TimGrundstein/cse_seminar_rechenautomat/misc/presentation/CSE_Seminar_Rechenmaschine.pdf

# Rekonstruktion &

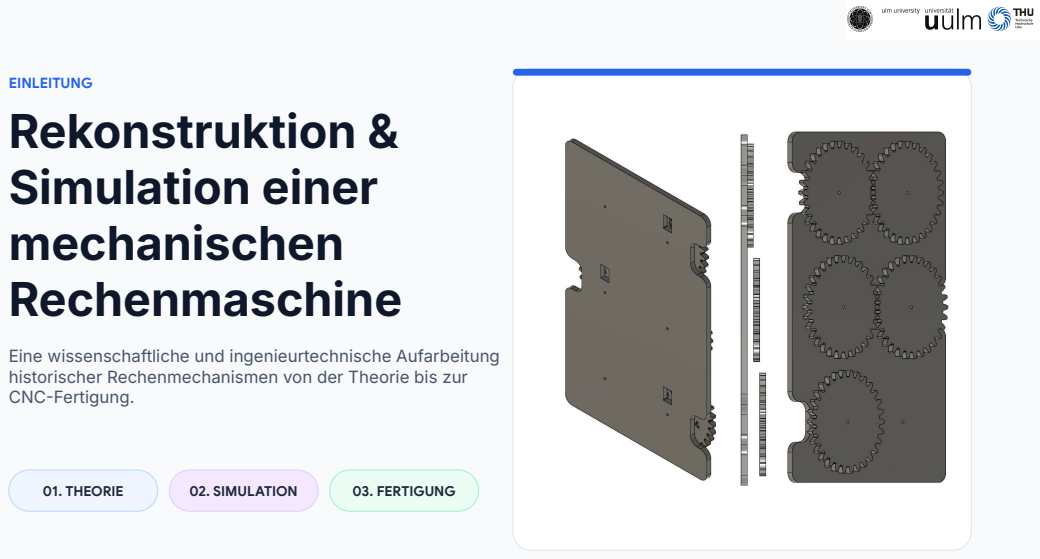
[picture p1: page 1]
EINLEITUNG Simulation einer mechanischen Rechenmaschine; 01. THEORIE; 02. SIMULATION; 03. FERTIGUNG

Eine wissenschaftliche und ingenieurtechnische Aufarbeitung
historischer Rechenmechanismen von der Theorie bis zur
CNCFertigung.

EINLEITUNG

# Gliederung

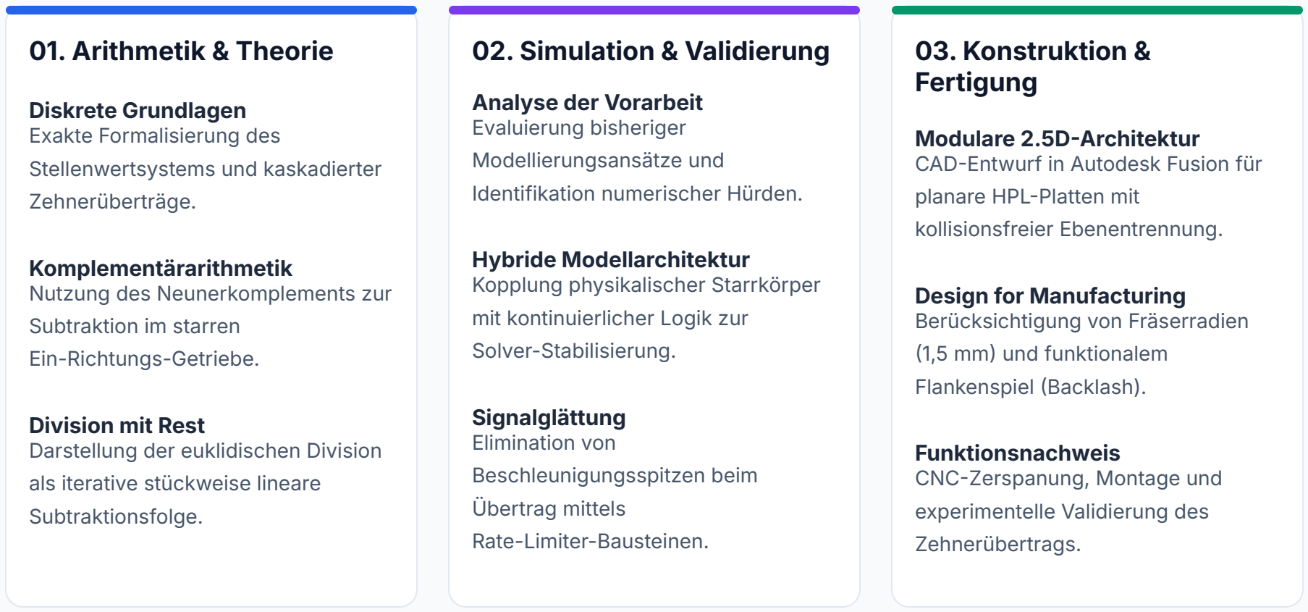
[picture p2: figure]
01. Arithmetik & Theorie; Diskrete Grundlagen Exakte Formalisierung des Stellenwertsystems und kaskadierter Zehnerüberträge.; Komplementärarithmetik Nutzung des Neunerkomplements zur Subtraktion im starren Ein-Richtungs-Getriebe.; Division mit Rest Darstellung der euklidischen Division als iterative stückweise lineare Subtraktionsfolge.; 02. Simulation & Validierung; Analyse der Vorarbeit Evaluierung bisheriger Modellierungsansätze und Identifikation numerischer Hürden.; Hybride Modellarchitektur Kopplung physikalischer Starrkörper mit kontinuierlicher Logik zur Solver-Stabilisierung.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

EINLEITUNG

# Methodik

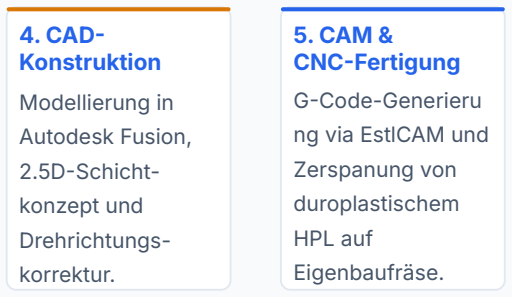
[picture p3: figure]
5. CAM & CNCFertigung GCode-Generieru ng via EstlCAM und Zerspanung von duroplastischem HPL auf Eigenbaufräse.; 4. CAD Konstruktion; Modellierung in Autodesk Fusion, 2.5DSchicht- konzept und Drehrichtungs- korrektur.

### 1. Theorie &

Historie
Analyse der
Pascaline, des
Sautoir-Prinzips
und der linearen
Komplementärarithmetik.

### 2. Vorarbeits-

analyse
Evaluierung der
Vorarbeit +
Identifikation
relevanter
Modellierungsansätze.

### 3. Hybride

Simulation
Aufbau des
Simscape- Modells
mit zehneckigen
Prismen und
diskretem
Sautoir-Code.

### 6. Test &

Synthese
Montage, Justage
mit Kontermuttern,
Toleranzanalyse
und Vergleich mit
3DDruck.

THEORIE & GRUNDLAGEN

# Die Pascaline

## Historischer Hintergrund & Motivation

Entstehungsanlass 1642
- Entwickelt von Blaise Pascal zur Unterstützung seines Vaters Étienne Pascal (königlicher Steuerkommissar in der Normandie)

Nicht-dezimales Währungssystem
- Historische Stückelung: 1 Livre = 20 Sous, 1 Sous = 12 Deniers → manuelle Abrechnung extrem fehleranfällig

Entwicklungsaufwand & Monopolprivileg
- Bau von rund 50 Prototypen bis 1645, sowie königliches Schutzprivileg durch Ludwig XIV. im Jahr 1649

Uhrmachertechnische Grenzen
- Hohe Reibung, Schmutzanfälligkeit und hohe Herstellungskosten begrenzten die damalige Verbreitung

https://press.christies.com/wp-content/uploads/2025/09/3f1f6d892af576e9f1f71e5117f32f54_330069-l.jpg

THEORIE & GRUNDLAGEN

# Kinematik & Aufbau der Pascaline

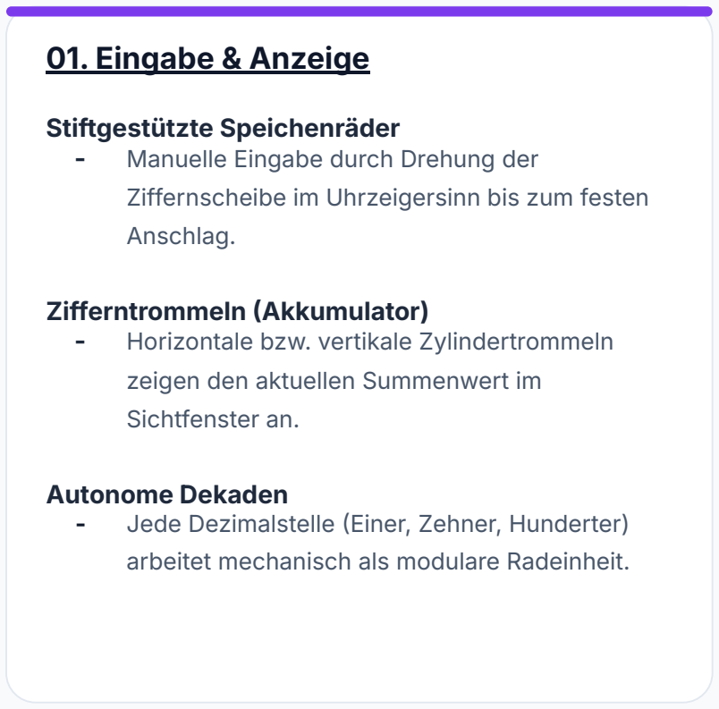
[picture p4: figure]
01. Eingabe & Anzeige; Stiftgestützte Speichenräder - Manuelle Eingabe durch Drehung der; Anschlag.; Zifferntrommeln Akkumulator); zeigen den aktuellen Summenwert im Sichtfenster an.; Autonome Dekaden; arbeitet mechanisch als modulare Radeinheit.

Ziffernscheibe im Uhrzeigersinn bis zum festen

- Horizontale bzw. vertikale Zylindertrommeln
- Jede Dezimalstelle Einer, Zehner, Hunderter)

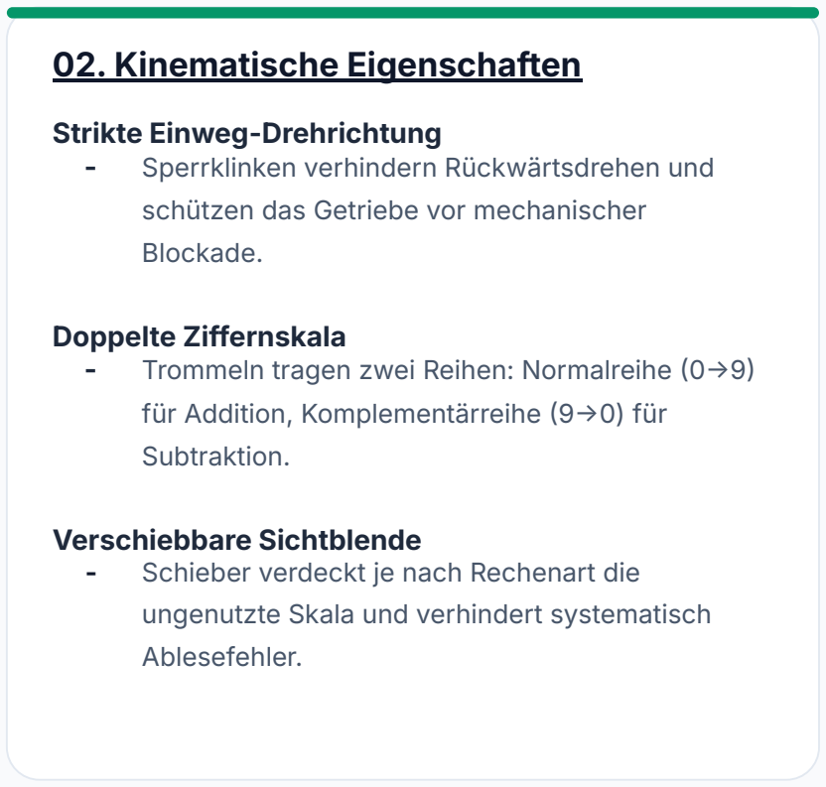
[picture p5: figure]
02. Kinematische Eigenschaften; Strikte Einweg-Drehrichtung; schützen das Getriebe vor mechanischer Blockade.; Doppelte Ziffernskala; für Addition, Komplementärreihe 90) für Subtraktion.; Verschiebbare Sichtblende; ungenutzte Skala und verhindert systematisch Ablesefehler.

- Sperrklinken verhindern Rückwärtsdrehen und
- Trommeln tragen zwei Reihen: Normalreihe 09
- Schieber verdeckt je nach Rechenart die

THEORIE & GRUNDLAGEN

# Der Sautoir: Schwerkraft-Zehnerübertrag

## Lösung des mechanischen Kaskadenproblems

Das mechanische Kaskadenproblem
- Bei simultanen Überträgen (z. B. 999 1) addieren sich die Reibungskräfte starr gekoppelter Räder auf und blockieren das Getriebe.

Schwerkraftgestützte Energiespeicherung
- Beim Drehen von 4 auf 9 hebt ein Nocken den Hebelarm Sautoir) kontinuierlich an und speichert potentielle Energie.

Schlagartiger Impulsübertrag
- Beim Übergang von 9 auf 0 fällt der Sautoir durch sein Eigengewicht herab und schaltet das Folgerad um z.B. 36° weiter.

Kinematische Entkopplung
- Die Antriebskraft des Bedieners wirkt nur lokal. Der Zehnerübertrag erfolgt energetisch autark.

https://upload.wikimedia.org/wikipedia/commons/b/b0/Sautoir-Animation.gif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

THEORIE & GRUNDLAGEN

# Subtraktion durch Neunerkomplement

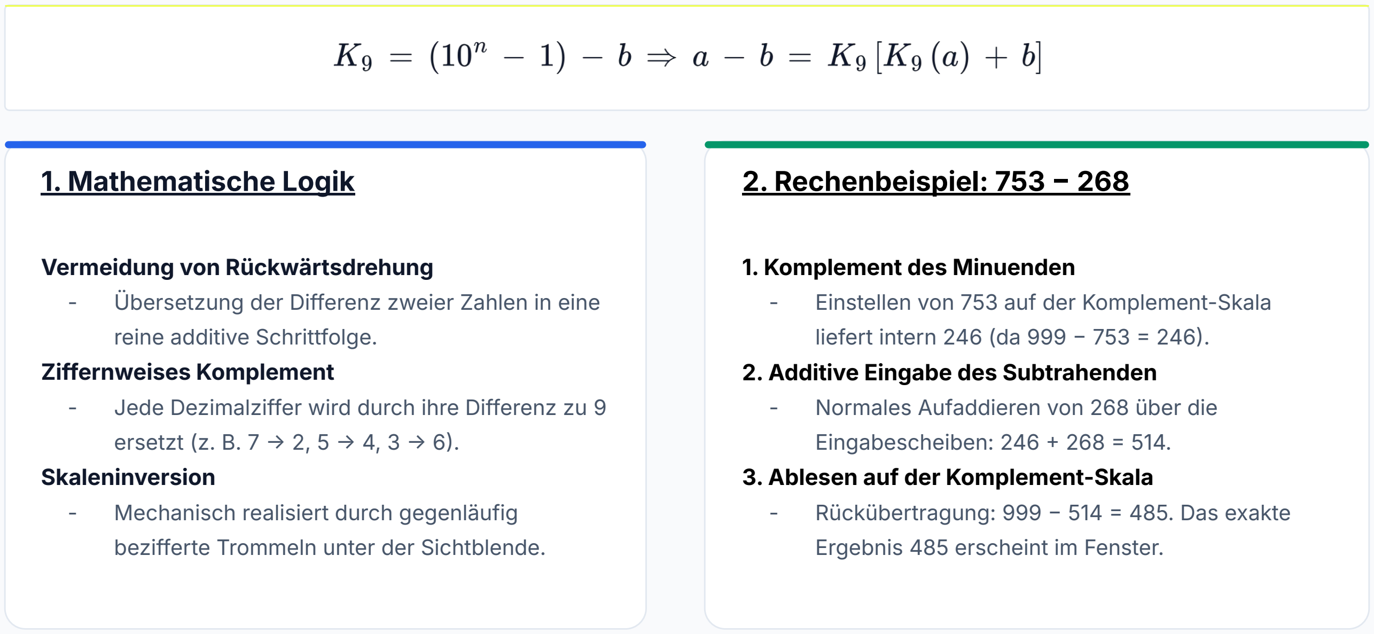
[picture p6: figure]
1. Mathematische Logik; Vermeidung von Rückwärtsdrehung; reine additive Schrittfolge. Ziffernweises Komplement; ersetzt (z. B. 7 2, 5 4, 3 6. Skaleninversion; bezifferte Trommeln unter der Sichtblende.; 2. Rechenbeispiel: 753 268; 1. Komplement des Minuenden; 2. Additive Eingabe des Subtrahenden - Normales Aufaddieren von 268 über die Eingabescheiben: 246 268 514. 3. Ablesen auf der Komplement-Skala; Ergebnis 485 erscheint im Fenster.

- Übersetzung der Differenz zweier Zahlen in eine
- Jede Dezimalziffer wird durch ihre Differenz zu 9
- Mechanisch realisiert durch gegenläufig
- Einstellen von 753 auf der Komplement-Skala liefert intern 246 (da 999 753 246.
- Rückübertragung: 999 514 485. Das exakte

THEORIE & GRUNDLAGEN

# Division mit Rest als lineare Schrittfunktion

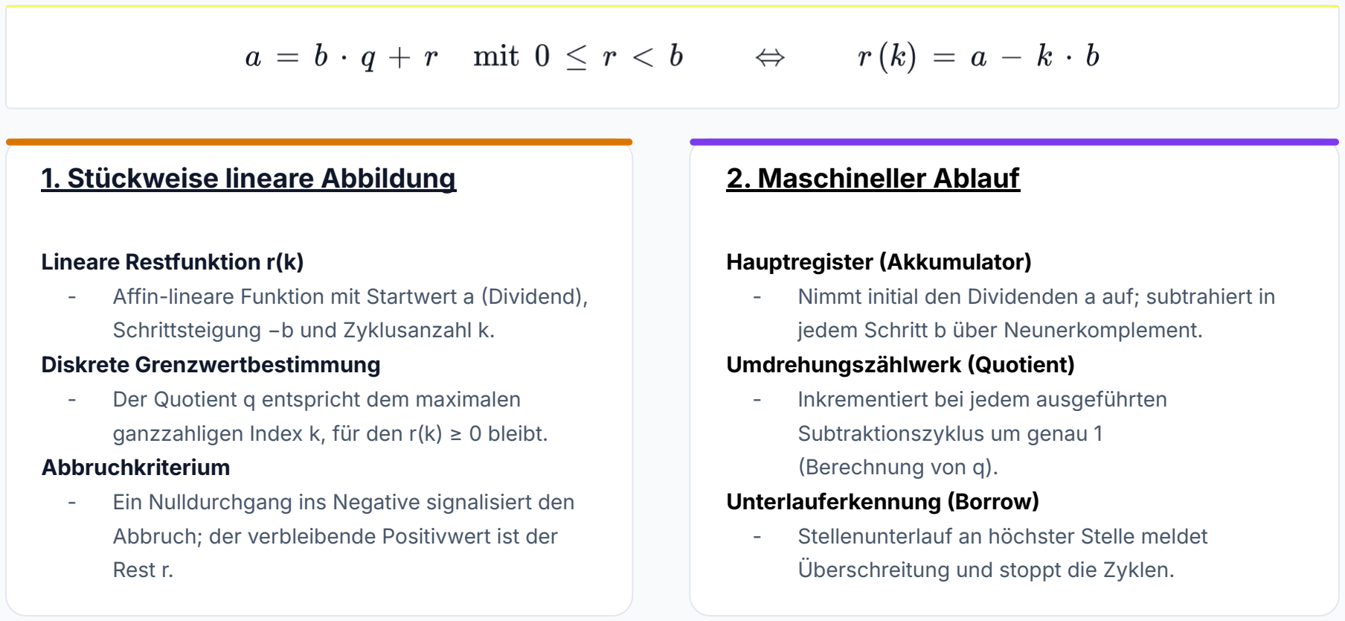
[picture p7: figure]
1. Stückweise lineare Abbildung; Lineare Restfunktion r(k); Schrittsteigung −b und Zyklusanzahl k. Diskrete Grenzwertbestimmung; Abbruchkriterium; Rest r.; 2. Maschineller Ablauf; Hauptregister Akkumulator); jedem Schritt b über Neunerkomplement. Umdrehungszählwerk Quotient) - Inkrementiert bei jedem ausgeführten Subtraktionszyklus um genau 1 Berechnung von q). Unterlauferkennung Borrow; Überschreitung und stoppt die Zyklen.

- Affin-lineare Funktion mit Startwert a Dividend),
- Der Quotient q entspricht dem maximalen ganzzahligen Index k, für den r(k) ≥ 0 bleibt.
- Ein Nulldurchgang ins Negative signalisiert den Abbruch; der verbleibende Positivwert ist der
- Nimmt initial den Dividenden a auf; subtrahiert in
- Stellenunterlauf an höchster Stelle meldet

THEORIE & GRUNDLAGEN

# Bestehende Modellierungsansätze

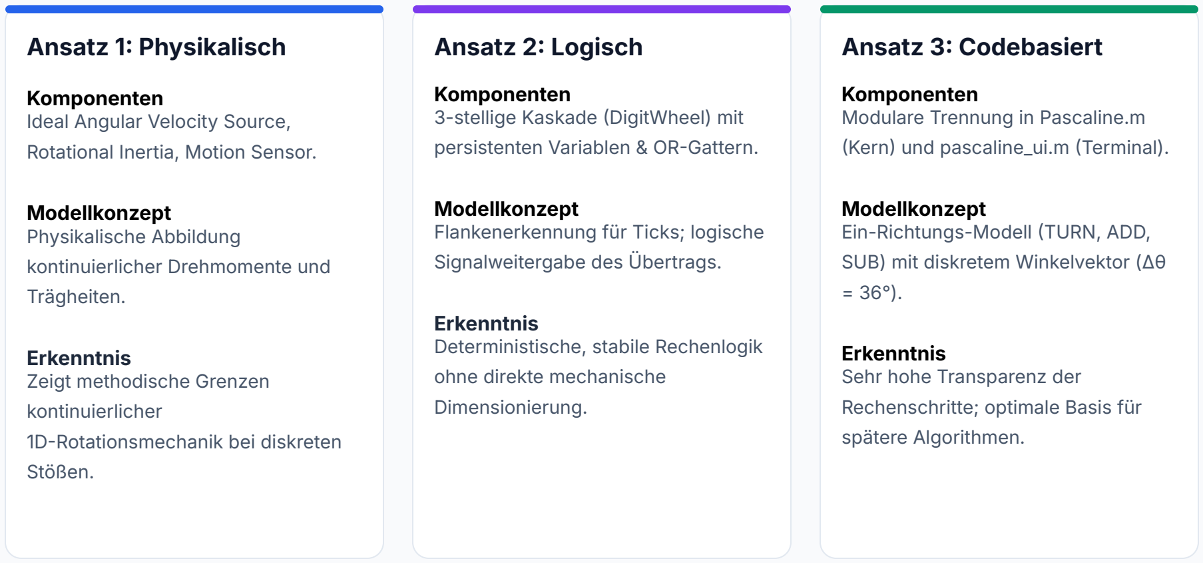
[picture p8: figure]
Ansatz 1 Physikalisch; Komponenten Ideal Angular Velocity Source, Rotational Inertia, Motion Sensor.; Modellkonzept Physikalische Abbildung kontinuierlicher Drehmomente und Trägheiten.; Erkenntnis Zeigt methodische Grenzen kontinuierlicher 1DRotationsmechanik bei diskreten Stößen.; Ansatz 2 Logisch; Komponenten 3-stellige Kaskade DigitWheel) mit persistenten Variablen & ORGattern.; Modellkonzept Flankenerkennung für Ticks; logische Signalweitergabe des Übertrags.; Erkenntnis Deterministische, stabile Rechenlogik ohne direkte mechanische Dimensionierung.; Ansatz 3 Codebasiert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

# Hybride Modellarchitektur (Simulink & Simscape)

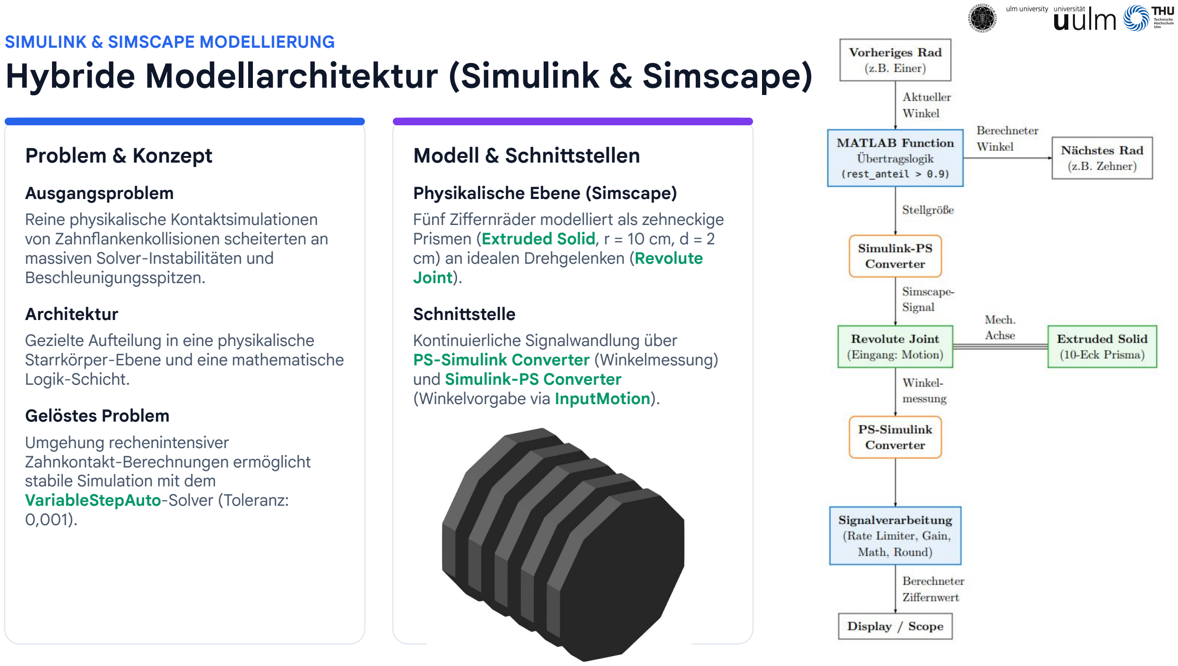
[picture p9: page 10]

SIMULINK & SIMSCAPE MODELLIERUNG

### Problem & Konzept

Ausgangsproblem
Reine physikalische Kontaktsimulationen von Zahnflankenkollisionen scheiterten an massiven Solver-Instabilitäten und Beschleunigungsspitzen.
Architektur
Gezielte Aufteilung in eine physikalische Starrkörper-Ebene und eine mathematische Logik-Schicht.
Gelöstes Problem
Umgehung rechenintensiver
Zahnkontakt-Berechnungen ermöglicht stabile Simulation mit dem VariableStepAuto-Solver (Toleranz: 0,001).

### Modell & Schnittstellen

Physikalische Ebene (Simscape) Fünf Ziffernräder modelliert als zehneckige Prismen (Extruded Solid, r = 10 cm, d = 2 cm) an idealen Drehgelenken (Revolute Joint).
Schnittstelle
Kontinuierliche Signalwandlung über PS-Simulink Converter (Winkelmessung) und Simulink-PS Converter
(Winkelvorgabe via InputMotion).

SIMULINK & SIMSCAPE MODELLIERUNG

# Implementierung der Logik & Digitaler Sautoir-Übertrag

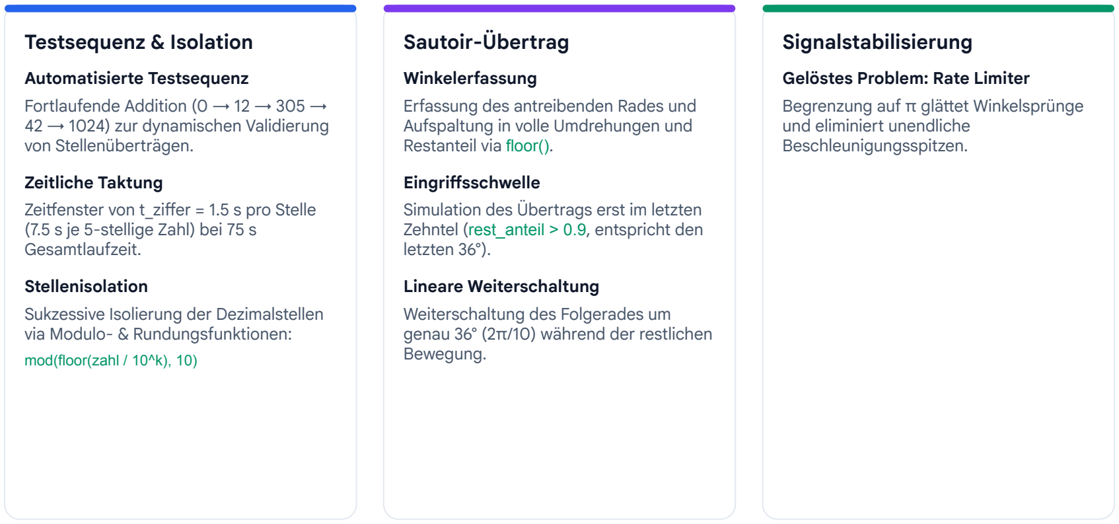
[picture p10: figure]
Testsequenz & Isolation; Automatisierte Testsequenz Fortlaufende Addition (0 → 12 → 305 → 42 → 1024) zur dynamischen Validierung von Stellenüberträgen.; Zeitliche Taktung; (7.5 s je 5-stellige Zahl) bei 75 s Gesamtlaufzeit.; Stellenisolation Sukzessive Isolierung der Dezimalstellen via Modulo- & Rundungsfunktionen:; mod(floor(zahl / 10^k), 10); Sautoir-Übertrag; Winkelerfassung Erfassung des antreibenden Rades und Aufspaltung in volle Umdrehungen und Restanteil via floor().; Eingriffsschwelle; letzten 36°).; Lineare Weiterschaltung Weiterschaltung des Folgerades um; Bewegung.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

Zeitfenster von t_ziffer = 1.5 s pro Stelle

Simulation des Übertrags erst im letzten Zehntel (rest_anteil > 0.9, entspricht den

genau 36° (2π/10) während der restlichen

SIMULINK & SIMSCAPE MODELLIERUNG

# Simulation

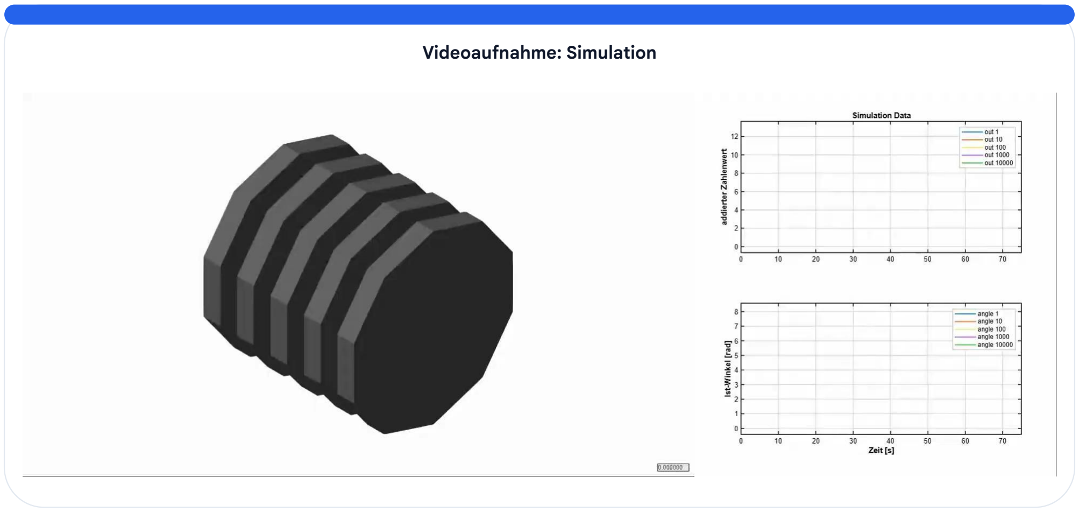
[picture p11: figure]
Videoaufnahme: Simulation

SIMULINK & SIMSCAPE MODELLIERUNG

# Gelöste vs. Offene Probleme in der Simulation

### Modellqualität & Stabilität (Gelöst)

Solver-Stabilität
Vollständige Beseitigung numerischer Solver-Abbrüche durch Abstraktion der Zahnkontakte.

Stellenübertrag
Korrekte Hintereinanderschaltung mehrstelliger Zehnerüberträge von der Einer- bis zur Zehntausenderstelle.

Arithmetische Logik
Mathematische Abbildung additiver Rechenoperationen sowie der Subtraktion über das Neunerkomplement.

Ablaufsicherheit
Vollautomatische, deterministische Ausführung von Berechnungsfolgen ohne externe Benutzereingriffe.

### Limitationen des Modells (Offen)

Keine reale Kontaktmechanik
Reale Zahnflankengeometrien, Kantenkollisionen und Spiel (Backlash) werden physikalisch nicht abgebildet.

Verlustfreie Lagerung
Drehgelenke sind idealisiert ohne viskose Dämpfung (Damping Coefficient = 0) oder Reibung modelliert.

Keine Kraftrückwirkung
Blockaden durch Fertigungstoleranzen oder Trägheitsmomente des Übertrags können simulativ so nicht detektiert werden.

# Roadmap zum physikalischen digitalen Zwilling

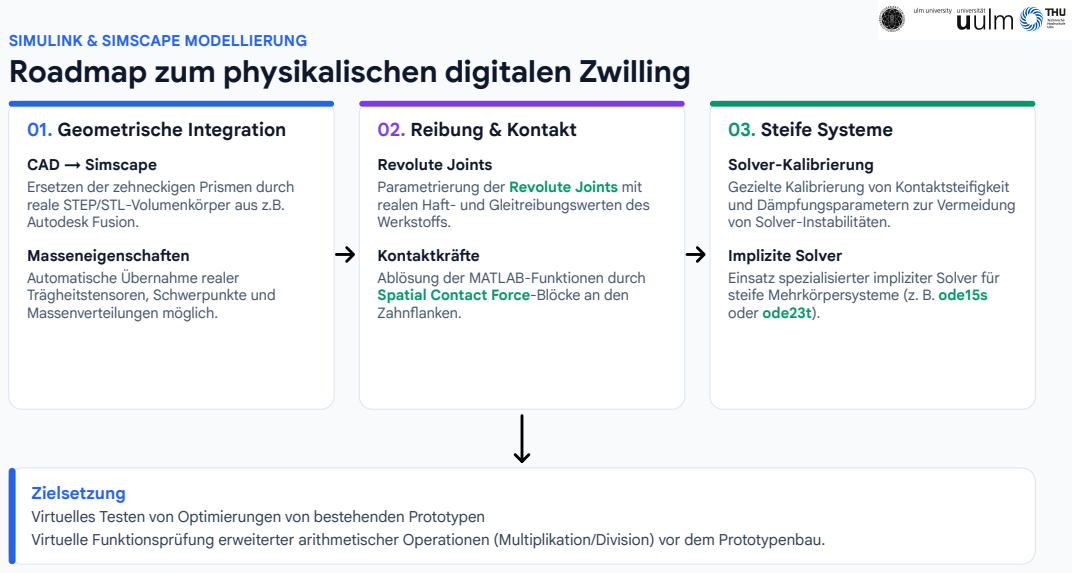
[picture p12: page 14]
01. Geometrische Integration; 02. Reibung & Kontakt; 03. Steife Systeme

SIMULINK & SIMSCAPE MODELLIERUNG

CAD → Simscape
Ersetzen der zehneckigen Prismen durch
reale STEP/STL-Volumenkörper aus z.B.
Autodesk Fusion.
Masseneigenschaften
Automatische Übernahme realer
Trägheitstensoren, Schwerpunkte und
Massenverteilungen möglich.

Revolute Joints
Parametrierung der Revolute Joints mit
realen Haft- und Gleitreibungswerten des
Werkstoffs.
Kontaktkräfte
Ablösung der MATLAB-Funktionen durch
Spatial Contact Force-Blöcke an den
Zahnflanken.

Solver-Kalibrierung
Gezielte Kalibrierung von Kontaktsteifigkeit
und Dämpfungsparametern zur Vermeidung
von Solver-Instabilitäten.
Implizite Solver
Einsatz spezialisierter impliziter Solver für
steife Mehrkörpersysteme (z. B. ode15s
oder ode23t).

Zielsetzung
Virtuelles Testen von Optimierungen von bestehenden Prototypen
Virtuelle Funktionsprüfung erweiterter arithmetischer Operationen (Multiplikation/Division) vor dem Prototypenbau.

Mechanische Konzeption

# Modulare Konzeption & Vorbilder

Physische Abbildung elementarer linearer mathematischer Berechnungen und Zehnerüberträge über ein mechanisches System.

### Historisches Vorbild (Pascaline)

Sautoir-Mechanismus
Klassischer schwerkraftgestützter Sautoir-Mechanismus als mechanisches Fundament.
Restriktion
Hohe dreidimensionale Komplexität historischer Uhrmachermechanik ist nicht direkt auf planare CNC-Plattenfertigung übertragbar.

### Modulares Konstruktionsprinzip

Open-Source-Adaption
Adaption moderner Open-Source-Konzepte zur Dekonstruktion der Rechenmaschine in autonome Dezimalstellen-Module. Modulumfang
Jedes Modul umfasst Ziffernrad, Achslagerung und Übertragselement.

Konsistenz zur Simulation: Das Modulprinzip spiegelt die kaskadierte Struktur der gekapselten Simulink-Subsysteme direkt in der Mechanik wider.
Skalierbarkeit: Beliebige Erweiterung um zusätzliche Dekaden sowie Vorbereitung für arithmetische Erweiterungen (Multiplikation/Division).

https://thumb.wikimedia.org/wikipedia/commons/thumb/8/80/Arts_et_Metiers_Pascaline_dsc03869.jpg/250px-Arts_et_Metiers_Pascaline_dsc03869.jpg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

# Kinematik & CAD-Umsetzung in Autodesk Fusion

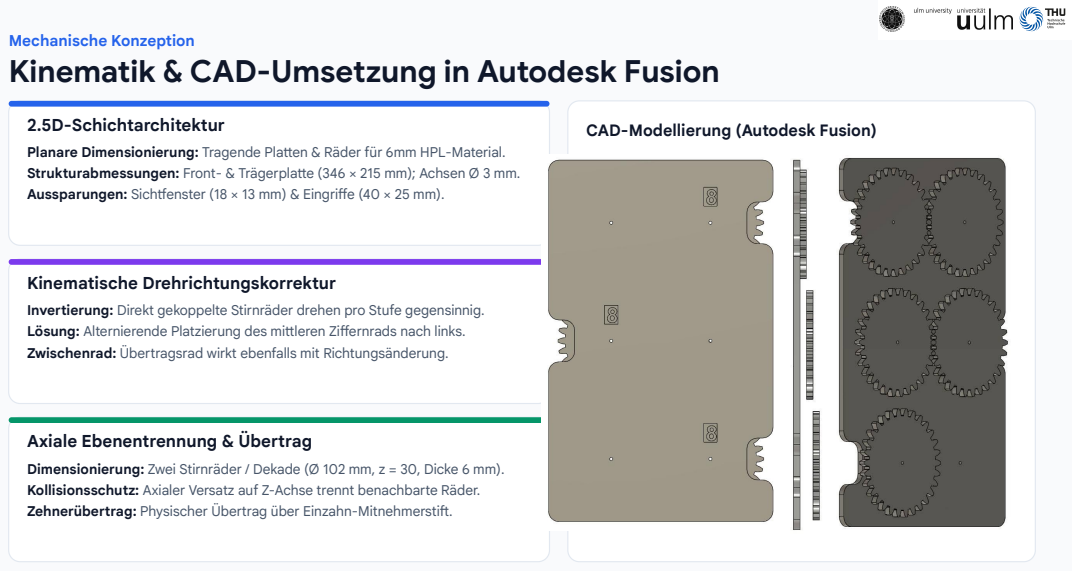
[picture p13: page 16]
Mechanische Konzeption

2.5D-Schichtarchitektur
Planare Dimensionierung: Tragende Platten & Räder für 6mm HPL-Material.
Strukturabmessungen: Front- & Trägerplatte (346 × 215 mm); Achsen Ø 3 mm.
Aussparungen: Sichtfenster (18 × 13 mm) & Eingriffe (40 × 25 mm).

CAD-Modellierung (Autodesk Fusion)

Kinematische Drehrichtungskorrektur
Invertierung: Direkt gekoppelte Stirnräder drehen pro Stufe gegensinnig.
Lösung: Alternierende Platzierung des mittleren Ziffernrads nach links.
Zwischenrad: Übertragsrad wirkt ebenfalls mit Richtungsänderung.

Axiale Ebenentrennung & Übertrag
Dimensionierung: Zwei Stirnräder / Dekade (Ø 102 mm, z = 30, Dicke 6 mm).
Kollisionsschutz: Axialer Versatz auf Z-Achse trennt benachbarte Räder.
Zehnerübertrag: Physischer Übertrag über Einzahn-Mitnehmerstift.

# Design for Manufacturing (DfM) & Toleranzen

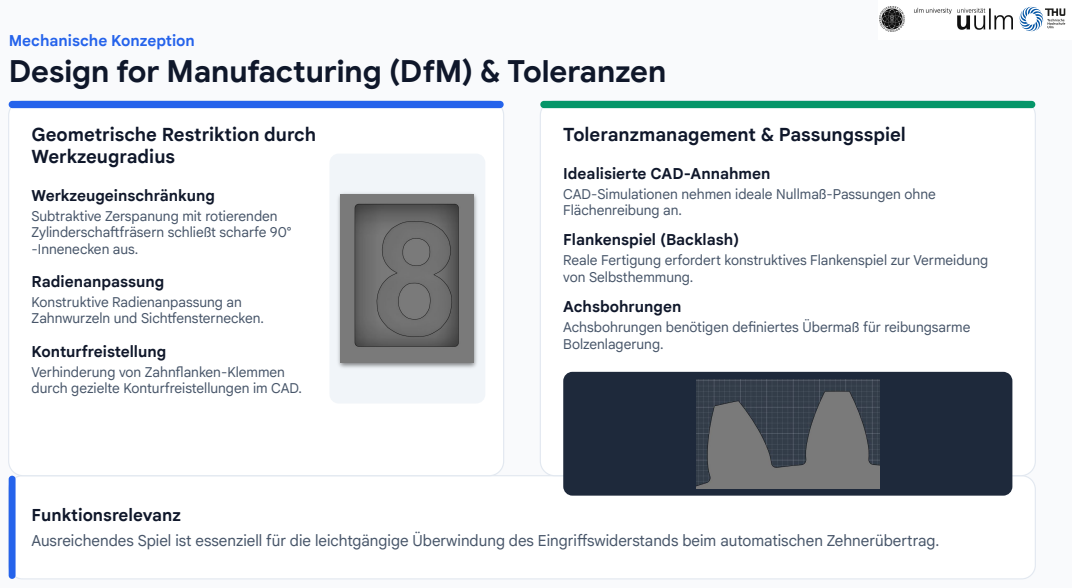
[picture p14: page 17]
Mechanische Konzeption; Toleranzmanagement & Passungsspiel

Geometrische Restriktion durch
Werkzeugradius

Idealisierte CAD-Annahmen
CAD-Simulationen nehmen ideale Nullmaß-Passungen ohne
Flächenreibung an.
Flankenspiel (Backlash)
Reale Fertigung erfordert konstruktives Flankenspiel zur Vermeidung
von Selbsthemmung.
Achsbohrungen
Achsbohrungen benötigen definiertes Übermaß für reibungsarme
Bolzenlagerung.

Werkzeugeinschränkung
Subtraktive Zerspanung mit rotierenden
Zylinderschaftfräsern schließt scharfe 90°
-Innenecken aus.
Radienanpassung
Konstruktive Radienanpassung an
Zahnwurzeln und Sichtfensternecken.
Konturfreistellung
Verhinderung von Zahnflanken-Klemmen
durch gezielte Konturfreistellungen im CAD.

Funktionsrelevanz
Ausreichendes Spiel ist essenziell für die leichtgängige Überwindung des Eingriffswiderstands beim automatischen Zehnerübertrag.

Mechanische Konzeption

# Konstruktionsanalyse: Gelöste vs. Offene Probleme

## Gelöste Probleme

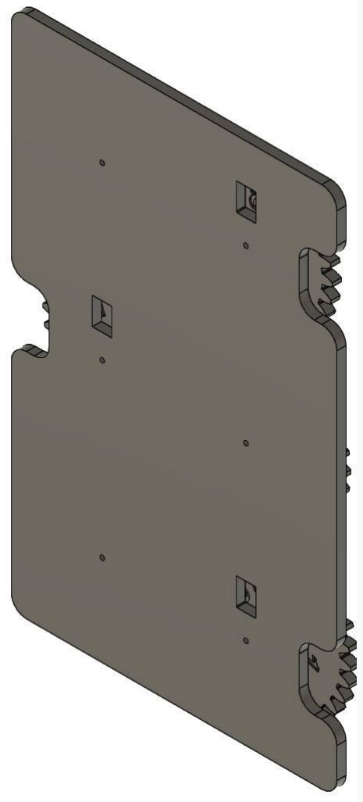
[picture p15: figure]

1. 2.5D-Schichtarchitektur
Überführung komplexer
3D-Getriebefunktionen in planare Plattengeometrien.

### 2. Drehrichtungskompensation

Einheitlicher Drehsinn für alle Eingabestellen durch alternierende Ebenenplatzierung.

### 3. Kollisionsfreie Ebenentrennung

Entkopplung benachbarter Rechenstufen durch definierten axialen Z-Versatz.

### 4. Einzahn-Übertrag

Konstruktive Zwangskopplung ersetzt die abstrakte MATLAB-Logik.

## Offene Probleme

### 1. Nullmaß-Modellierung

Fertigungstoleranzen und Passungsspiele nicht im CAD parametrisiert; erzwingt Nacharbeit.

### 2. Fehlender Formschluss

Übertragszeiger nicht als formschlüssige Nut-Feder-Baugruppe mit dem Rad integriert.

### 3. Fehlende Rastmechanik

Keine mechanische Blockade, die Über- oder Rückwärtsdrehen formschlüssig blockiert.

Fräsprozess & Montage

# CAM-Strategie, Materialwahl & Zerspanung

Duroplastisches Plattenmaterial (HPL)
Material: 6 mm HPL-Kompaktplatten.
Vorteil vs. Thermoplaste: Hohe Zerspanbarkeit ohne Aufschmelzen oder Werkzeugverkleben unter Reibungshitze.

Maschinenkonfiguration & Zerspanung
Portalfräse: ~100 kg, 1370 mm x 1220 mm x 530 mm, Kugelgewinde, Steppermotor (3 Nm, 2 kW), EstlCAM.
Parameter: Ø 1,5 mm Fräser, 15.000 U/min (S15000), Vorschub 1000 mm/min (F1000).
Präzision: ~0,1 mm Genauigkeit; Zustellung in 3 Durchgängen à 2 mm Tiefe.

Gelöstes Fertigungsproblem (Helikales Fräsen)
Problem: 3 mm Achsbohrungen nicht im Einstech-Bohrzyklus fertigbar. Lösung: Taschenausschnitt mit zirkularer Interpolation (G02), Fräser schraubt sich spiralförmig ein.

CAM-Visualisierung & Fräsprozess

Fräsprozess & Montage

# Fräsen

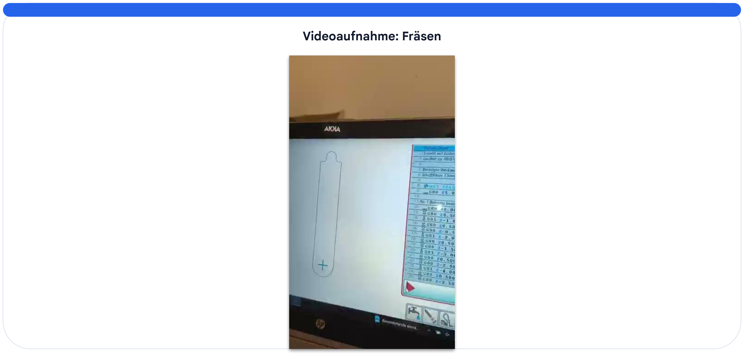
[picture p16: figure]
Videoaufnahme: Fräsen

Fräsprozess & Montage

# Physische Montage, Schichtaufbau & Justage

Realisierung der 2.5D-Ebenentrennung
Distanzscheiben: Fräsen zylindrischer Scheiben (Ø 30 mm, Dicke 6 mm) aus HPL-Resten.
Kaskadierter Z-Versatz: Obere Ebene 0 mm, mittlere Ebene 6 mm (1 Scheibe), untere Ebene 12 mm (2 Scheiben).

Axialspiel-Einstellung an den Drehachsen
Lagerung: Lagerung aller Zahnräder über M3-Gewindeschrauben und Muttern. Gelöstes Justageproblem: Reibungsminimierung bei gleichzeitigem Verhindern von unkontrolliertem Verdrehen durch Kontermuttern gesichert.

Zeigeranpassung & Winkelsynchronisation
Übertragszeiger: Mitnehmer separat gefräst, mit Heißkleber fixiert (manuelles Anrauen).
Kollisionsproblem gelöst: Zeigerspitzen von 6mm auf 3 mm abgefräst für freies Gleiten.
Winkelsynchronisation: Präzise Montage; Eingriff beim Nulldurchgang (9→0) um 36°.

Physische Baugruppe & Schichtaufbau

# Funktionstest: Gelöste vs. Offene Probleme am Prototyp

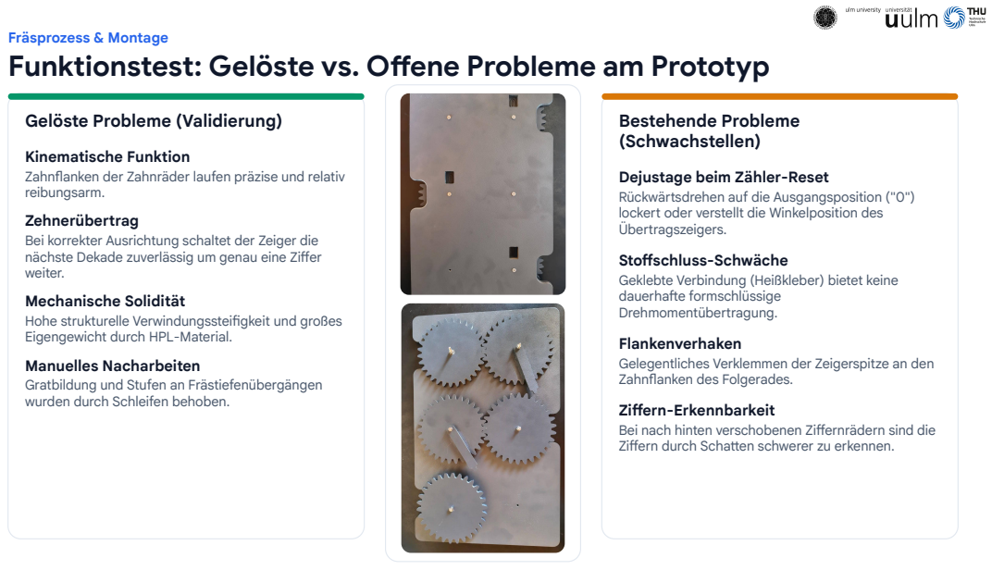
[picture p17: page 22]
Fräsprozess & Montage; Bestehende Probleme (Schwachstellen)

Gelöste Probleme (Validierung)

Kinematische Funktion
Zahnflanken der Zahnräder laufen präzise und relativ
reibungsarm.
Zehnerübertrag
Bei korrekter Ausrichtung schaltet der Zeiger die
nächste Dekade zuverlässig um genau eine Ziffer
weiter.
Mechanische Solidität
Hohe strukturelle Verwindungssteifigkeit und großes
Eigengewicht durch HPL-Material.
Manuelles Nacharbeiten
Gratbildung und Stufen an Frästiefenübergängen
wurden durch Schleifen behoben.

Dejustage beim Zähler-Reset
Rückwärtsdrehen auf die Ausgangsposition ("0")
lockert oder verstellt die Winkelposition des
Übertragszeigers.
Stoffschluss-Schwäche
Geklebte Verbindung (Heißkleber) bietet keine
dauerhafte formschlüssige
Drehmomentübertragung.
Flankenverhaken
Gelegentliches Verklemmen der Zeigerspitze an den
Zahnflanken des Folgerades.
Ziffern-Erkennbarkeit
Bei nach hinten verschobenen Ziffernrädern sind die
Ziffern durch Schatten schwerer zu erkennen.

Fräsprozess & Montage

# Vergleich: CNC-Fräsen vs. 3D-Druck

CNC-Fräsen (Subtraktiv)

Fertigungsaufwand
Hoher Vorschub (1000 mm/min), aber hoher manueller Montageaufwand.
Geometriefreiheit
Auf 2.5D beschränkt; Mindestradius durch Fräser (1,5 mm). Bauteilintegration
Mehrteilig: Zeiger geklebt, separate Distanzscheiben. Oberflächenreibung
Extrem glatte Duroplast-Flanken (geringe Reibung).

3D-Druck (Additiv)

Fertigungsaufwand
Längere Maschinenlaufzeit, minimale manuelle Montagezeit (Bauteilkonsolidierung).
Geometriefreiheit
Volle 3D-Freiheit; scharfe Zahnwurzeln und Hinterschneidungen machbar.
Bauteilintegration
Monolithisch: Zahnrad, Zeiger und Achsabstand als ein Bauteil druckbar.
Oberflächenreibung
Fused Deposition Modeling (FDM): Rillenbildung (Staircase-Effekt) erhöht Reibung; Stereolithografie (SLA) als glatte Alternative.

Optimierungskonzept: Hybrid Manufacturing
Kombination beider Verfahren für Folgeprojekte:

Strukturbauteile (Subtraktiv)
Front- und Rückplatte weiterhin formstabil und verzugsfrei aus HPL fräsen. Sonst großer Materialaufwand. Kinematikkomponenten (Additiv)
Übertragsräder samt Einzahn, Nabe und möglicher Rastmechanik monolithisch per SLA-Druck fertigen.

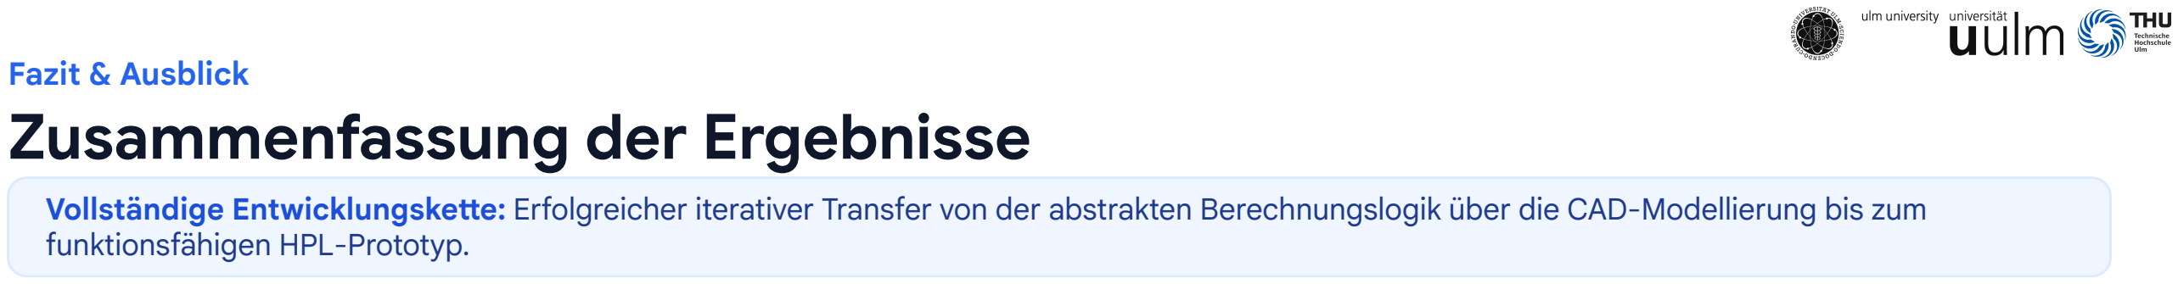
[picture p18: figure]
Fazit & Ausblick Zusammenfassung der Ergebnisse; funktionsfähigen HPL-Prototyp.

Vollständige Entwicklungskette: Erfolgreicher iterativer Transfer von der abstrakten Berechnungslogik über die CAD-Modellierung bis zum

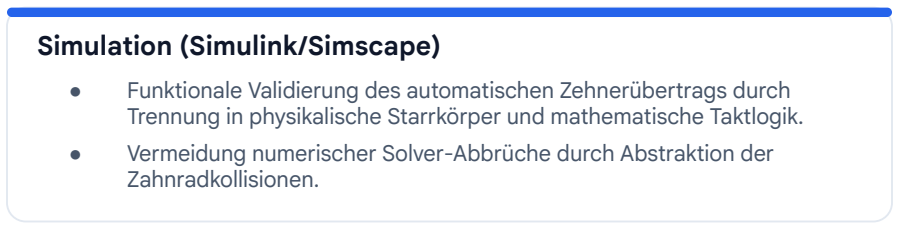
[picture p19: figure]
Simulation (Simulink/Simscape); Zahnradkollisionen.
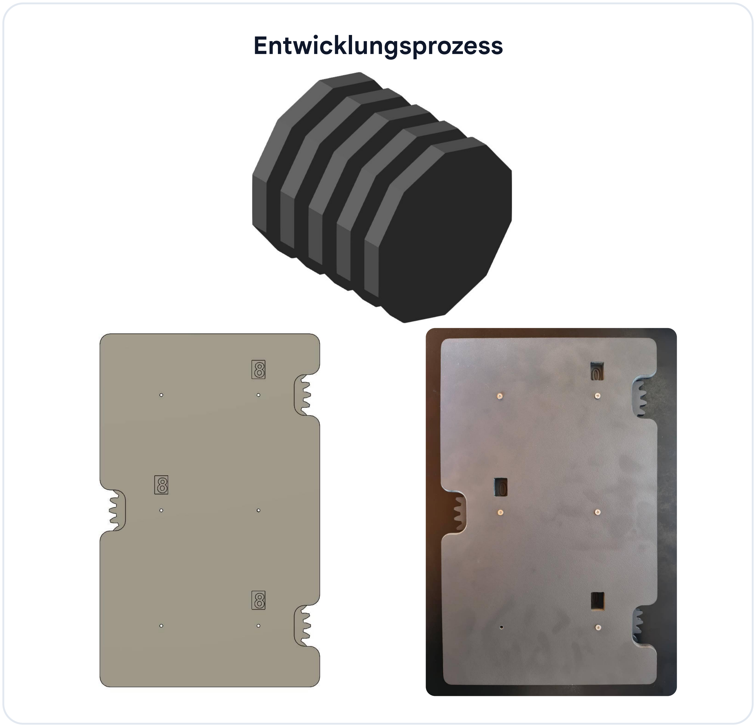
[picture p20: figure]
Entwicklungsprozess

- Funktionale Validierung des automatischen Zehnerübertrags durch Trennung in physikalische Starrkörper und mathematische Taktlogik.
- Vermeidung numerischer Solver-Abbrüche durch Abstraktion der

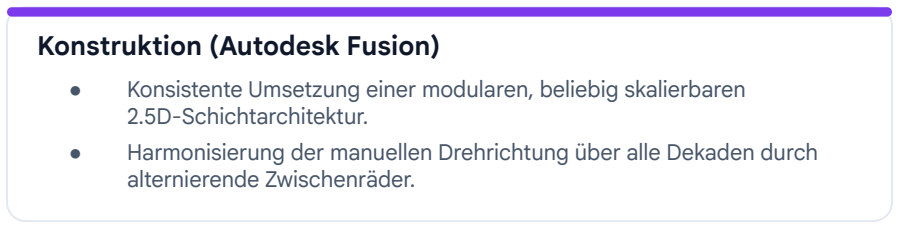
[picture p21: figure]
Konstruktion (Autodesk Fusion); 2.5D-Schichtarchitektur.; alternierende Zwischenräder.

- Konsistente Umsetzung einer modularen, beliebig skalierbaren
- Harmonisierung der manuellen Drehrichtung über alle Dekaden durch

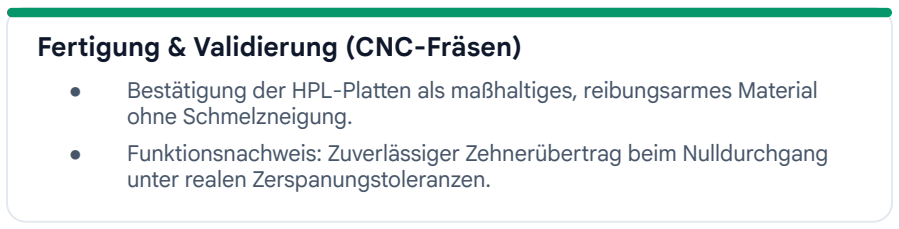
[picture p22: figure]
Fertigung & Validierung (CNC-Fräsen); ohne Schmelzneigung.; unter realen Zerspanungstoleranzen.

- Bestätigung der HPL-Platten als maßhaltiges, reibungsarmes Material
- Funktionsnachweis: Zuverlässiger Zehnerübertrag beim Nulldurchgang

Fazit & Ausblick

# Reflexion: Erkenntnisgewinn & Systemgrenzen

Bestätigte Methoden & Hypothesen

### 1. Hybride Simulation als Enabler für Mehrkörpersysteme

Die strikte Trennung von starrer Körperdynamik (Simscape) und diskreter Taktlogik (Simulink) ist zwingend erforderlich, um Kontaktinstabilitäten bei steifen Flankenstößen numerisch beherrschbar zu machen.

### 2. Realisierbarkeit planarer Schichtarchitekturen (2.5D)

Komplexe räumliche Uhrmachermechanik (Pascaline) lässt sich ohne Funktionsverlust in flache, kaskadierte Ebenen überführen – der Drehrichtungswechsel wird durch alternierende Zwischenräder vollwertig kompensiert.

### 3. Materialeignung von Hochdruck-Duroplasten (HPL)

HPL erweist sich durch hohe Zerspanungssteifigkeit und absolute Verzugsfreiheit gegenüber schmelzanfälligen Standard-Thermoplasten als exzellenter Werkstoff für feingliedrige Trockenlauf-Getriebe.

Konstruktive Lehren & Systemgrenzen

### 1. Stoffschluss versus Formschluss in der Kinematik

Nachträglich aufgeklebte Übertragszeiger bilden das schwächste Glied der Kette; dynamisch beanspruchte Getriebekomponenten erfordern prinzipbedingt monolithische Bauteile oder definierte Passfedern.

### 2. Notwendigkeit von Zwangssperren (Detents)

Das bloße Kämmen von Zähnen genügt im praktischen Betrieb nicht: Ohne mechanische Rastungen führen Rückwärtsdrehungen oder unpräzises Nullstellen (Reset) unweigerlich zur Phasendejustage.

### 3. Priorisierung von Design for Manufacturing (DfM)

Idealisierte Nullmaß-Geometrien im CAD verlagern den Abstimmungsaufwand in die Montage. Flankenspiel (Backlash) und Achstoleranzen müssen primär parametrisch im CAD verankert sein, nicht manuell nachgearbeitet werden.

Fazit & Ausblick

# Roadmap für Folgeprojekte

Hardware-Optimierung (Hybrid Manufacturing):

Subtraktive Basis
Beibehaltung der formstabilen HPL-Platten für tragende Front- und Trägerstrukturen.
Additive Bauteilkonsolidierung
3D-Druck (SLA-Verfahren) zur Vereinigung von Zahnrad, Abstandshalter und Zeiger in ein monolithisches Bauteil.
Formschluss & Rastung
Integration definierter Nut-Feder-Verbindungen und Einrastmechaniken (Detents) zur Sicherung der Synchronisation beim Reset.

Digitale Rückkopplung (Physikalischer digitaler Zwilling):

CAD-Reimport
Einbinden realer STEP-Modelle in Simscape Multibody zur automatischen Trägheits- und Massenberechnung.
Reale Kontaktmechanik
Ablösung der MATLAB-Code-Logik durch Spatial Contact Force-Blöcke unter Nutzung der experimentell ermittelten Reibwerte und Spiele.

Funktionale Erweiterung:
Simulative und mechanische Skalierung
Skalierung für höhere Rechenoperationen (Multiplikation und Division mittels Staffelwalzen oder Rechenwerken).
