TimGrundstein/cse_seminar_rechenautomat/misc/cad/CSE_Seminar_Rechenmaschine.step

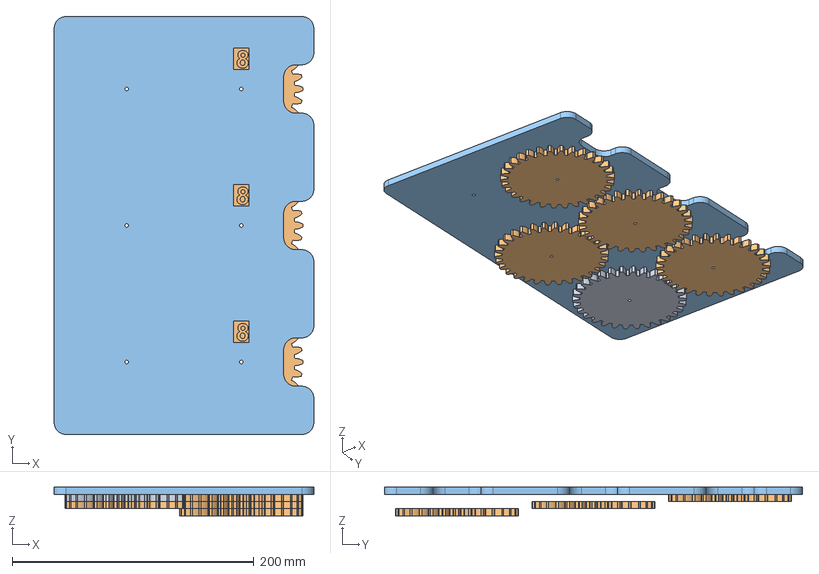
[picture p47: CAD file, 2026-10-02]
misc/cad/CSE_Seminar_Rechenmaschine.step
215.0 x 346.0 x 24.0 mm
