TimGrundstein/cse_seminar_rechenautomat/misc/cad/CSE_Seminar_Rechenmaschine_Zeiger.step

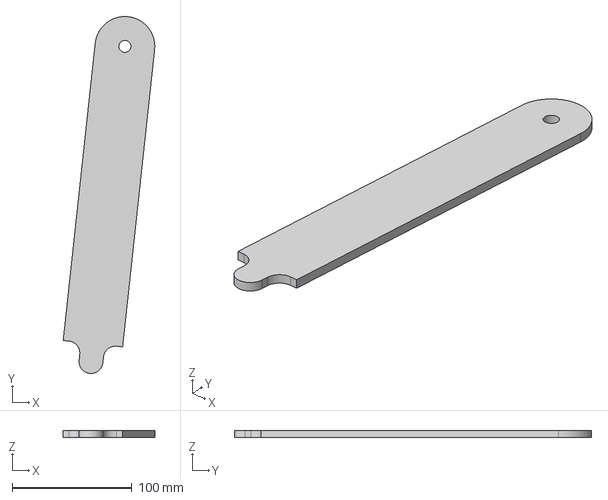
[picture p48: CAD file, 2026-10-02]
misc/cad/CSE_Seminar_Rechenmaschine_Zeiger.step
76.6 x 298.5 x 6.00 mm
