TimGrundstein/cse_seminar_rechenautomat/(commit log)

2026-05-26 not working correclty, split the different wheels from another and added a function to calculate when the next wheel should turn
2026-05-26 working, wheels now turning correctly and changed their orientation
2026-06-01 not working correctly, the hundret wheel jumps and resets and jumps again when its his turn to turn, added more wheels and induvidual inputs for wheels
2026-10-02 added CAD-files and presentation with videos
    [CSE_Seminar_Rechenmaschine.step, CSE_Seminar_Rechenmaschine_Zeiger.step]
